mdonahue1/Ltu_FSAE_electric_Temp_sense/(list of files, drawings)

Other design files:
Schematics/Altium/Copy of temp sense 2.0,uhh.PcbDoc
Schematics/Altium/MCU.SchDoc
Schematics/Altium/mux side A (1-4).SchDoc
Schematics/Altium/Mux side B (5-8).SchDoc
Schematics/Altium/power input.SchDoc
Schematics/Altium/temp sense 2.0 top.SchDoc
Schematics/Altium/temp sense 2.0,uhh.PcbDoc
Schematics/Altium/Temp_sense_Project 2.0 - leviathan.PcbDoc
Schematics/Altium/Temp_sense_Project 2.0(right angle.PcbDoc
Schematics/Altium/Temp_sense_Project 2.0.PcbDoc
Schematics/Altium/Temp_sense_Project 2.0.PrjPcb
