mdonahue1/Ltu_FSAE_electric_Temp_sense/Schematics/KiCad/Temp_sense_Project 2.0.kicad_pcb

## KiCad design Schematics/KiCad/Temp_sense_Project 2.0.kicad_pcb (2026-03-20)

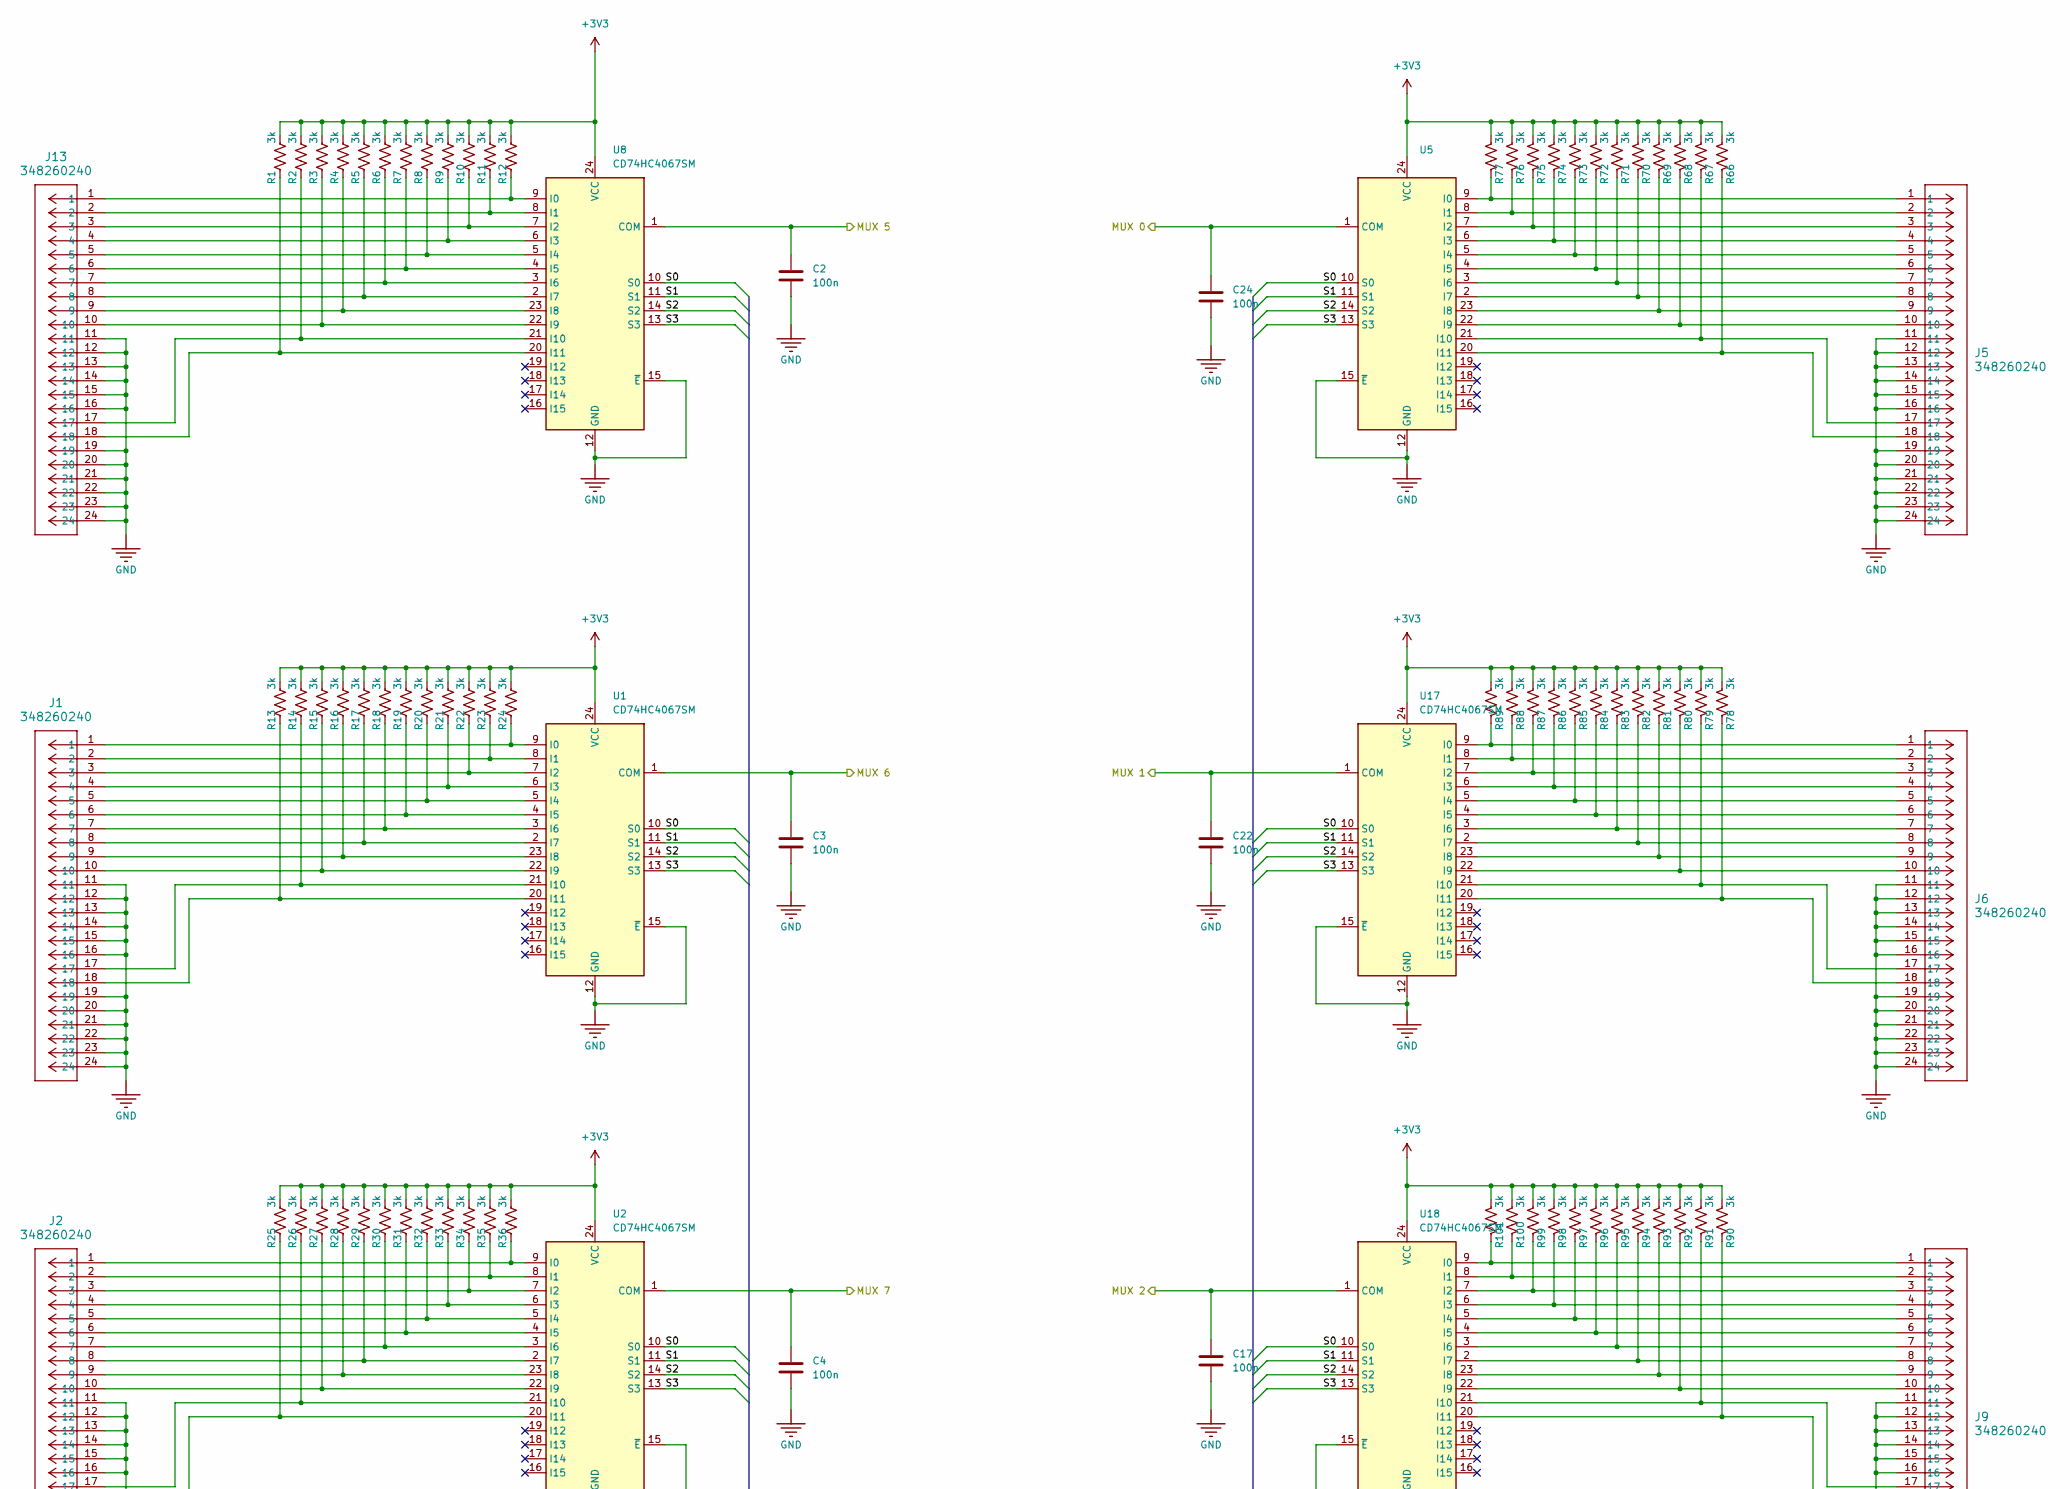
[picture p1: schematic mux side A (1-4).kicad_sch, part in row 1, column 1]

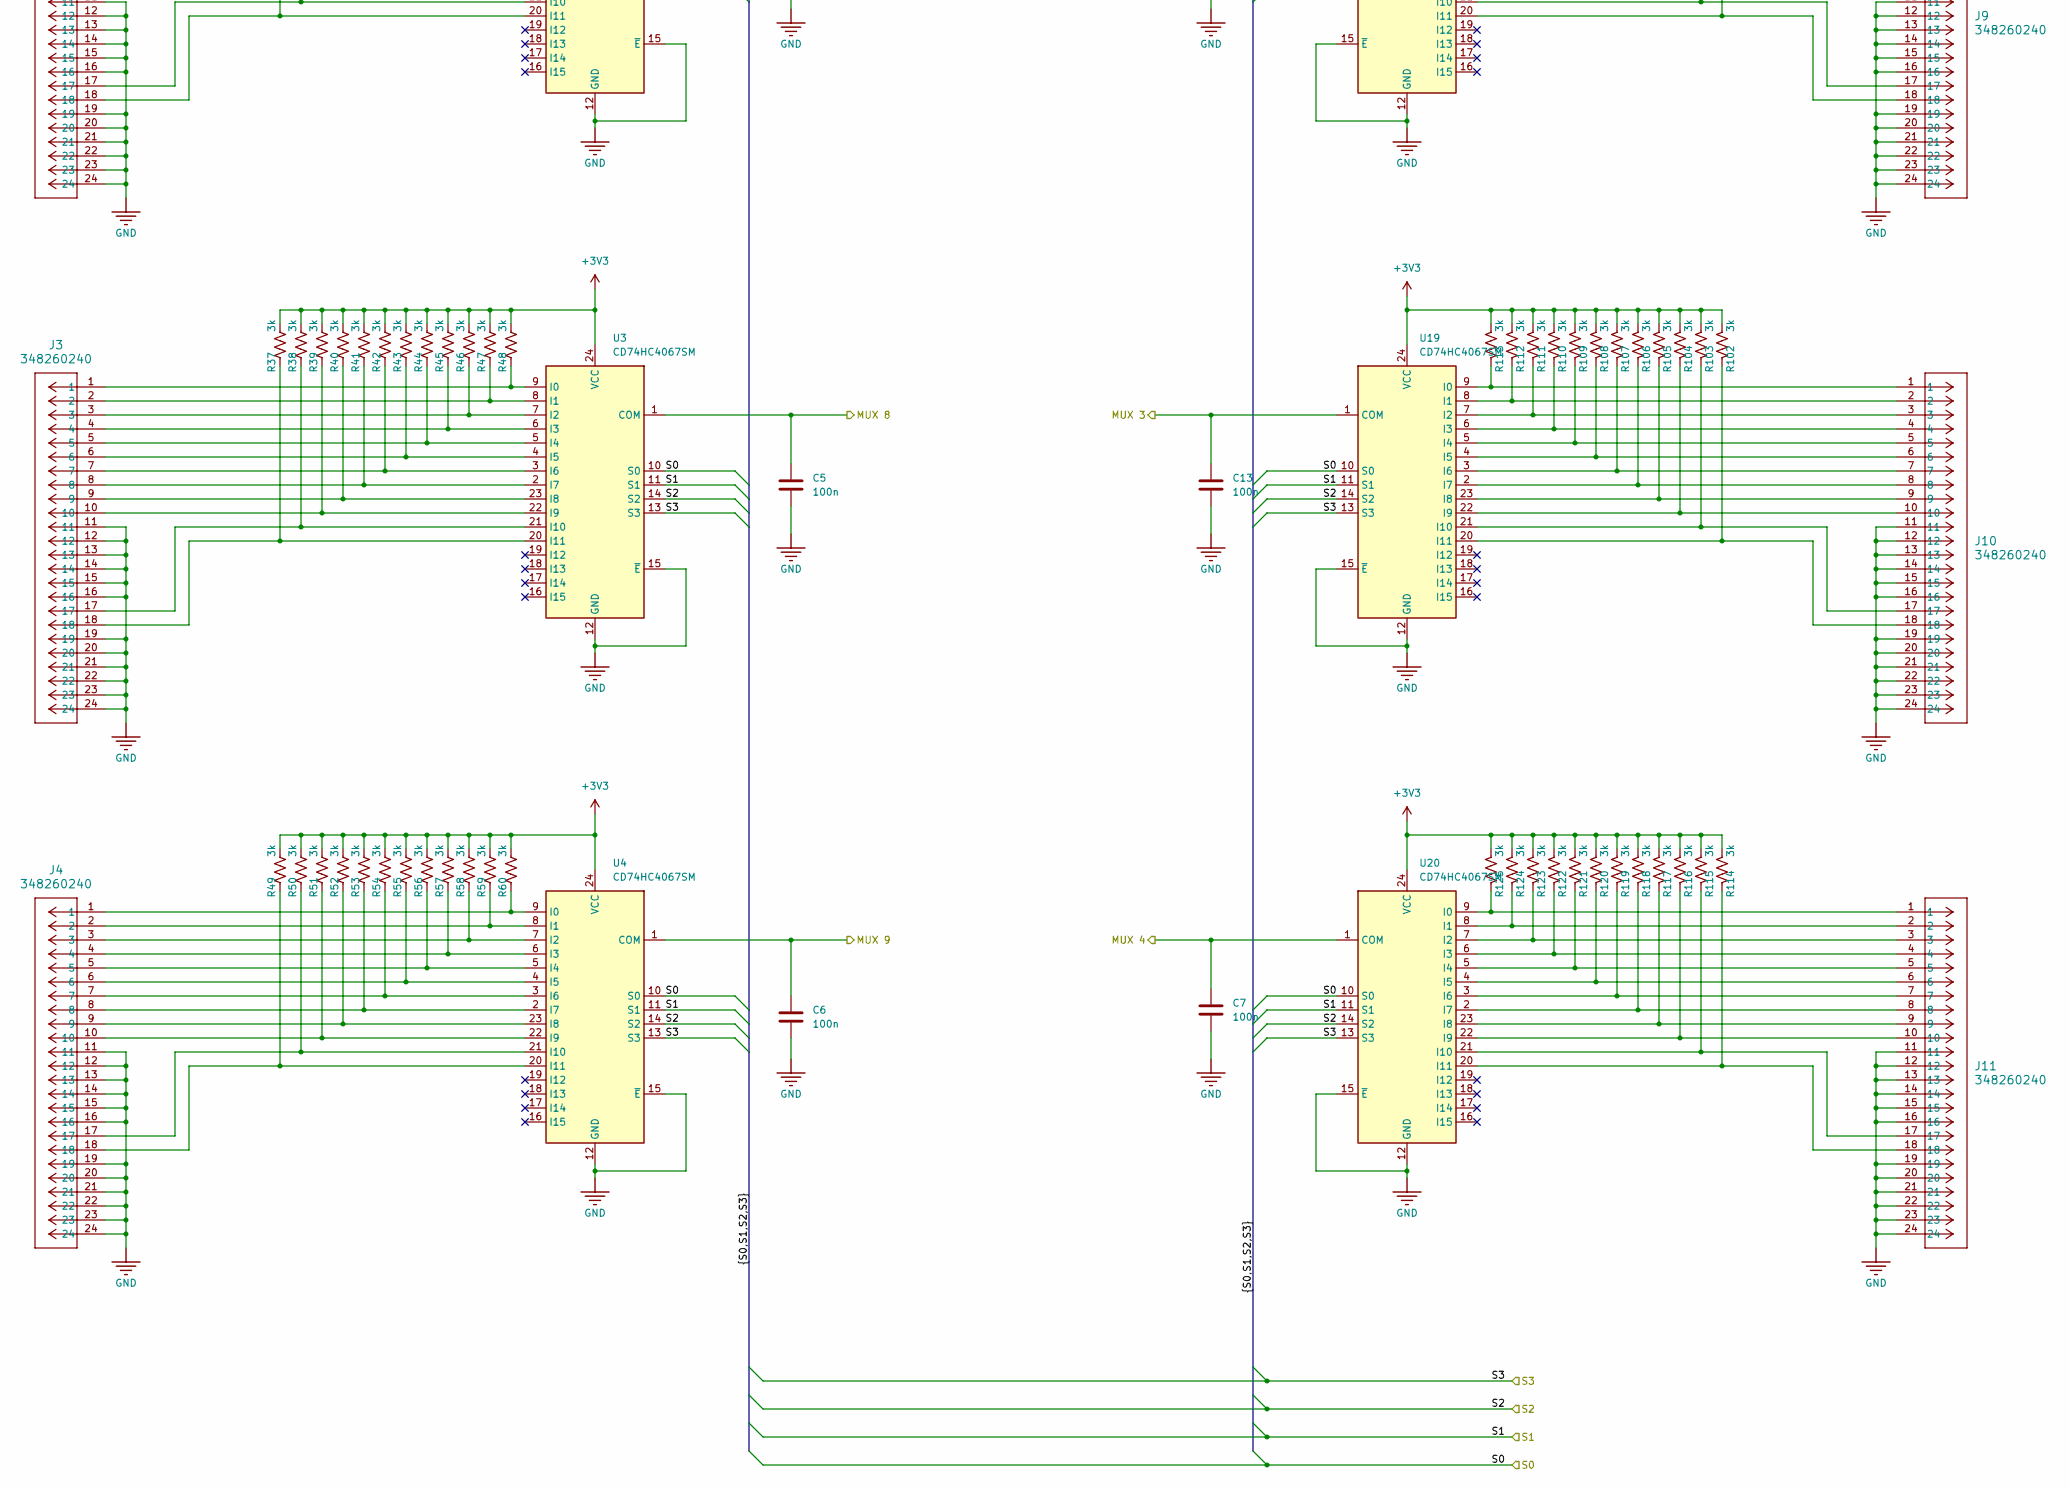
[picture p2: schematic mux side A (1-4).kicad_sch, part in row 2, column 1]

Parts:
C2, C3, C4, C5, C6, C7, C13, C17, C22, C24: 100n; C_0603_1608Metric
J1, J2, J3, J4, J5, J6, J9, J10, J11, J13: 348260240; CONN_SD-34826-001_24_MOL
R1, R2, R3, R4, R5, R6, R7, R8, R9, R10, R11, R12, R13, R14, R15, R16, R17, R18, R19, R20, R21, R22, R23, R24, R25, R26, R27, R28, R29, R30, R31, R32, R33, R34, R35, R36, R37, R38, R39, R40, R41, R42, R43, R44, R45, R46, R47, R48, R49, R50, R51, R52, R53, R54, R55, R56, R57, R58, R59, R60, R66, R67, R68, R69, R70, R71, R72, R73, R74, R75, R76, R77, R78, R79, R80, R81, R82, R83, R84, R85, R86, R87, R88, R89, R90, R91, R92, R93, R94, R95, R96, R97, R98, R99, R100, R101, R102, R103, R104, R105, R106, R107, R108, R109, R110, R111, R112, R113, R114, R115, R116, R117, R118, R119, R120, R121, R122, R123, R124, R125: 3k; R_0603_1608Metric
U1, U2, U3, U4, U5, U8, U17, U18, U19, U20: CD74HC4067SM; SSOP-24_5.3x8.2mm_P0.65mm

Connections:
+3V3: R1.1, R2.1, R3.1, R4.1, R5.1, R6.1, R7.1, R8.1, R9.1, R10.1, R11.1, R12.1, R13.1, R14.1, R15.1, R16.1, R17.1, R18.1, R19.1, R20.1, R21.1, R22.1, R23.1, R24.1, R25.1, R26.1, R27.1, R28.1, R29.1, R30.1, R31.1, R32.1, R33.1, R34.1, R35.1, R36.1, R37.1, R38.1, R39.1, R40.1, R41.1, R42.1, R43.1, R44.1, R45.1, R46.1, R47.1, R48.1, R49.1, R50.1, R51.1, R52.1, R53.1, R54.1, R55.1, R56.1, R57.1, R58.1, R59.1, R60.1, R66.1, R67.1, R68.1, R69.1, R70.1, R71.1, R72.1, R73.1, R74.1, R75.1, R76.1, R77.1, R78.1, R79.1, R80.1, R81.1, R82.1, R83.1, R84.1, R85.1, R86.1, R87.1, R88.1, R89.1, R90.1, R91.1, R92.1, R93.1, R94.1, R95.1, R96.1, R97.1, R98.1, R99.1, R100.1, R101.1, R102.1, R103.1, R104.1, R105.1, R106.1, R107.1, R108.1, R109.1, R110.1, R111.1, R112.1, R113.1, R114.1, R115.1, R116.1, R117.1, R118.1, R119.1, R120.1, R121.1, R122.1, R123.1, R124.1, R125.1, U1.24 (VCC), U2.24 (VCC), U3.24 (VCC), U4.24 (VCC), U5.24 (VCC), U8.24 (VCC), U17.24 (VCC), U18.24 (VCC), U19.24 (VCC), U20.24 (VCC); also elsewhere on the board
/MCU/MUX 0: C24.1, U5.1 (COM); also elsewhere on the board
/MCU/MUX 1: C22.1, U17.1 (COM); also elsewhere on the board
/MCU/MUX 2: C17.1, U18.1 (COM); also elsewhere on the board
/MCU/MUX 3: C13.1, U19.1 (COM); also elsewhere on the board
/MCU/MUX 4: C7.1, U20.1 (COM); also elsewhere on the board
/MCU/MUX 5: C2.1, U8.1 (COM); also elsewhere on the board
/MCU/MUX 6: C3.1, U1.1 (COM); also elsewhere on the board
/MCU/MUX 7: C4.1, U2.1 (COM); also elsewhere on the board
/MCU/MUX 8: C5.1, U3.1 (COM); also elsewhere on the board
/MCU/MUX 9: C6.1, U4.1 (COM); also elsewhere on the board
/MCU/S0: U1.10 (S0), U2.10 (S0), U3.10 (S0), U4.10 (S0), U5.10 (S0), U8.10 (S0), U17.10 (S0), U18.10 (S0), U19.10 (S0), U20.10 (S0); also elsewhere on the board
/MCU/S1: U1.11 (S1), U2.11 (S1), U3.11 (S1), U4.11 (S1), U5.11 (S1), U8.11 (S1), U17.11 (S1), U18.11 (S1), U19.11 (S1), U20.11 (S1); also elsewhere on the board
/MCU/S2: U1.14 (S2), U2.14 (S2), U3.14 (S2), U4.14 (S2), U5.14 (S2), U8.14 (S2), U17.14 (S2), U18.14 (S2), U19.14 (S2), U20.14 (S2); also elsewhere on the board
/MCU/S3: U1.13 (S3), U2.13 (S3), U3.13 (S3), U4.13 (S3), U5.13 (S3), U8.13 (S3), U17.13 (S3), U18.13 (S3), U19.13 (S3), U20.13 (S3); also elsewhere on the board
GND: C2.2, C3.2, C4.2, C5.2, C6.2, C7.2, C13.2, C17.2, C22.2, C24.2, J1.11, J1.12, J1.13, J1.14, J1.15, J1.16, J1.19, J1.20, J1.21, J1.22, J1.23, J1.24, J2.11, J2.12, J2.13, J2.14, J2.15, J2.16, J2.19, J2.20, J2.21, J2.22, J2.23, J2.24, J3.11, J3.12, J3.13, J3.14, J3.15, J3.16, J3.19, J3.20, J3.21, J3.22, J3.23, J3.24, J4.11, J4.12, J4.13, J4.14, J4.15, J4.16, J4.19, J4.20, J4.21, J4.22, J4.23, J4.24, J5.11, J5.12, J5.13, J5.14, J5.15, J5.16, J5.19, J5.20, J5.21, J5.22, J5.23, J5.24, J6.11, J6.12, J6.13, J6.14, J6.15, J6.16, J6.19, J6.20, J6.21, J6.22, J6.23, J6.24, J9.11, J9.12, J9.13, J9.14, J9.15, J9.16, J9.19, J9.20, J9.21, J9.22, J9.23, J9.24, J10.11, J10.12, J10.13, J10.14, J10.15, J10.16, J10.19, J10.20, J10.21, J10.22, J10.23, J10.24, J11.11, J11.12, J11.13, J11.14, J11.15, J11.16, J11.19, J11.20, J11.21, J11.22, J11.23, J11.24, J13.11, J13.12, J13.13, J13.14, J13.15, J13.16, J13.19, J13.20, J13.21, J13.22, J13.23, J13.24, U1.12 (GND), U1.15 (~E), U2.12 (GND), U2.15 (~E), U3.12 (GND), U3.15 (~E), U4.12 (GND), U4.15 (~E), U5.12 (GND), U5.15 (~E), U8.12 (GND), U8.15 (~E), U17.12 (GND), U17.15 (~E), U18.12 (GND), U18.15 (~E), U19.12 (GND), U19.15 (~E), U20.12 (GND), U20.15 (~E); also elsewhere on the board
unnamed: J1.1, R24.2, U1.9 (I0)
unnamed: J1.2, R23.2, U1.8 (I1)
unnamed: J1.3, R22.2, U1.7 (I2)
unnamed: J1.4, R21.2, U1.6 (I3)
unnamed: J1.5, R20.2, U1.5 (I4)
unnamed: J1.6, R19.2, U1.4 (I5)
unnamed: J1.7, R18.2, U1.3 (I6)
unnamed: J1.8, R17.2, U1.2 (I7)
unnamed: J1.9, R16.2, U1.23 (I8)
unnamed: J1.10, R15.2, U1.22 (I9)
unnamed: J1.17, R14.2, U1.21 (I10)
unnamed: J1.18, R13.2, U1.20 (I11)
unnamed: J2.1, R36.2, U2.9 (I0)
unnamed: J2.2, R35.2, U2.8 (I1)
unnamed: J2.3, R34.2, U2.7 (I2)
unnamed: J2.4, R33.2, U2.6 (I3)
unnamed: J2.5, R32.2, U2.5 (I4)
unnamed: J2.6, R31.2, U2.4 (I5)
unnamed: J2.7, R30.2, U2.3 (I6)
unnamed: J2.8, R29.2, U2.2 (I7)
unnamed: J2.9, R28.2, U2.23 (I8)
unnamed: J2.10, R27.2, U2.22 (I9)
unnamed: J2.17, R26.2, U2.21 (I10)
unnamed: J2.18, R25.2, U2.20 (I11)
unnamed: J3.1, R48.2, U3.9 (I0)
unnamed: J3.2, R47.2, U3.8 (I1)
unnamed: J3.3, R46.2, U3.7 (I2)
unnamed: J3.4, R45.2, U3.6 (I3)
unnamed: J3.5, R44.2, U3.5 (I4)
unnamed: J3.6, R43.2, U3.4 (I5)
unnamed: J3.7, R42.2, U3.3 (I6)
unnamed: J3.8, R41.2, U3.2 (I7)
unnamed: J3.9, R40.2, U3.23 (I8)
unnamed: J3.10, R39.2, U3.22 (I9)
unnamed: J3.17, R38.2, U3.21 (I10)
unnamed: J3.18, R37.2, U3.20 (I11)
unnamed: J4.1, R60.2, U4.9 (I0)
unnamed: J4.2, R59.2, U4.8 (I1)
unnamed: J4.3, R58.2, U4.7 (I2)
unnamed: J4.4, R57.2, U4.6 (I3)
unnamed: J4.5, R56.2, U4.5 (I4)
unnamed: J4.6, R55.2, U4.4 (I5)
unnamed: J4.7, R54.2, U4.3 (I6)
unnamed: J4.8, R53.2, U4.2 (I7)
unnamed: J4.9, R52.2, U4.23 (I8)
unnamed: J4.10, R51.2, U4.22 (I9)
unnamed: J4.17, R50.2, U4.21 (I10)
unnamed: J4.18, R49.2, U4.20 (I11)
unnamed: J5.1, R77.2, U5.9 (I0)
unnamed: J5.2, R76.2, U5.8 (I1)
unnamed: J5.3, R75.2, U5.7 (I2)
unnamed: J5.4, R74.2, U5.6 (I3)
unnamed: J5.5, R73.2, U5.5 (I4)
unnamed: J5.6, R72.2, U5.4 (I5)
unnamed: J5.7, R71.2, U5.3 (I6)
unnamed: J5.8, R70.2, U5.2 (I7)
unnamed: J5.9, R69.2, U5.23 (I8)
unnamed: J5.10, R68.2, U5.22 (I9)
unnamed: J5.17, R67.2, U5.21 (I10)
unnamed: J5.18, R66.2, U5.20 (I11)
unnamed: J13.1, R12.2, U8.9 (I0)
unnamed: J13.2, R11.2, U8.8 (I1)
unnamed: J13.3, R10.2, U8.7 (I2)
unnamed: J13.4, R9.2, U8.6 (I3)
unnamed: J13.5, R8.2, U8.5 (I4)
unnamed: J13.6, R7.2, U8.4 (I5)
unnamed: J13.7, R6.2, U8.3 (I6)
unnamed: J13.8, R5.2, U8.2 (I7)
unnamed: J13.9, R4.2, U8.23 (I8)
unnamed: J13.10, R3.2, U8.22 (I9)
unnamed: J13.17, R2.2, U8.21 (I10)
unnamed: J13.18, R1.2, U8.20 (I11)
unnamed: J6.1, R89.2, U17.9 (I0)
unnamed: J6.2, R88.2, U17.8 (I1)
unnamed: J6.3, R87.2, U17.7 (I2)
unnamed: J6.4, R86.2, U17.6 (I3)
unnamed: J6.5, R85.2, U17.5 (I4)
unnamed: J6.6, R84.2, U17.4 (I5)
unnamed: J6.7, R83.2, U17.3 (I6)
unnamed: J6.8, R82.2, U17.2 (I7)
unnamed: J6.9, R81.2, U17.23 (I8)
unnamed: J6.10, R80.2, U17.22 (I9)
unnamed: J6.17, R79.2, U17.21 (I10)
unnamed: J6.18, R78.2, U17.20 (I11)
unnamed: J9.1, R101.2, U18.9 (I0)
unnamed: J9.2, R100.2, U18.8 (I1)
unnamed: J9.3, R99.2, U18.7 (I2)
unnamed: J9.4, R98.2, U18.6 (I3)
unnamed: J9.5, R97.2, U18.5 (I4)
unnamed: J9.6, R96.2, U18.4 (I5)
unnamed: J9.7, R95.2, U18.3 (I6)
unnamed: J9.8, R94.2, U18.2 (I7)
unnamed: J9.9, R93.2, U18.23 (I8)
unnamed: J9.10, R92.2, U18.22 (I9)
unnamed: J9.17, R91.2, U18.21 (I10)
unnamed: J9.18, R90.2, U18.20 (I11)
unnamed: J10.1, R113.2, U19.9 (I0)
unnamed: J10.2, R112.2, U19.8 (I1)
unnamed: J10.3, R111.2, U19.7 (I2)
unnamed: J10.4, R110.2, U19.6 (I3)
unnamed: J10.5, R109.2, U19.5 (I4)
unnamed: J10.6, R108.2, U19.4 (I5)
unnamed: J10.7, R107.2, U19.3 (I6)
unnamed: J10.8, R106.2, U19.2 (I7)
unnamed: J10.9, R105.2, U19.23 (I8)
unnamed: J10.10, R104.2, U19.22 (I9)
unnamed: J10.17, R103.2, U19.21 (I10)
unnamed: J10.18, R102.2, U19.20 (I11)
unnamed: J11.1, R125.2, U20.9 (I0)
unnamed: J11.2, R124.2, U20.8 (I1)
unnamed: J11.3, R123.2, U20.7 (I2)
unnamed: J11.4, R122.2, U20.6 (I3)
unnamed: J11.5, R121.2, U20.5 (I4)
unnamed: J11.6, R120.2, U20.4 (I5)
unnamed: J11.7, R119.2, U20.3 (I6)
unnamed: J11.8, R118.2, U20.2 (I7)
unnamed: J11.9, R117.2, U20.23 (I8)
unnamed: J11.10, R116.2, U20.22 (I9)
unnamed: J11.17, R115.2, U20.21 (I10)
unnamed: J11.18, R114.2, U20.20 (I11)

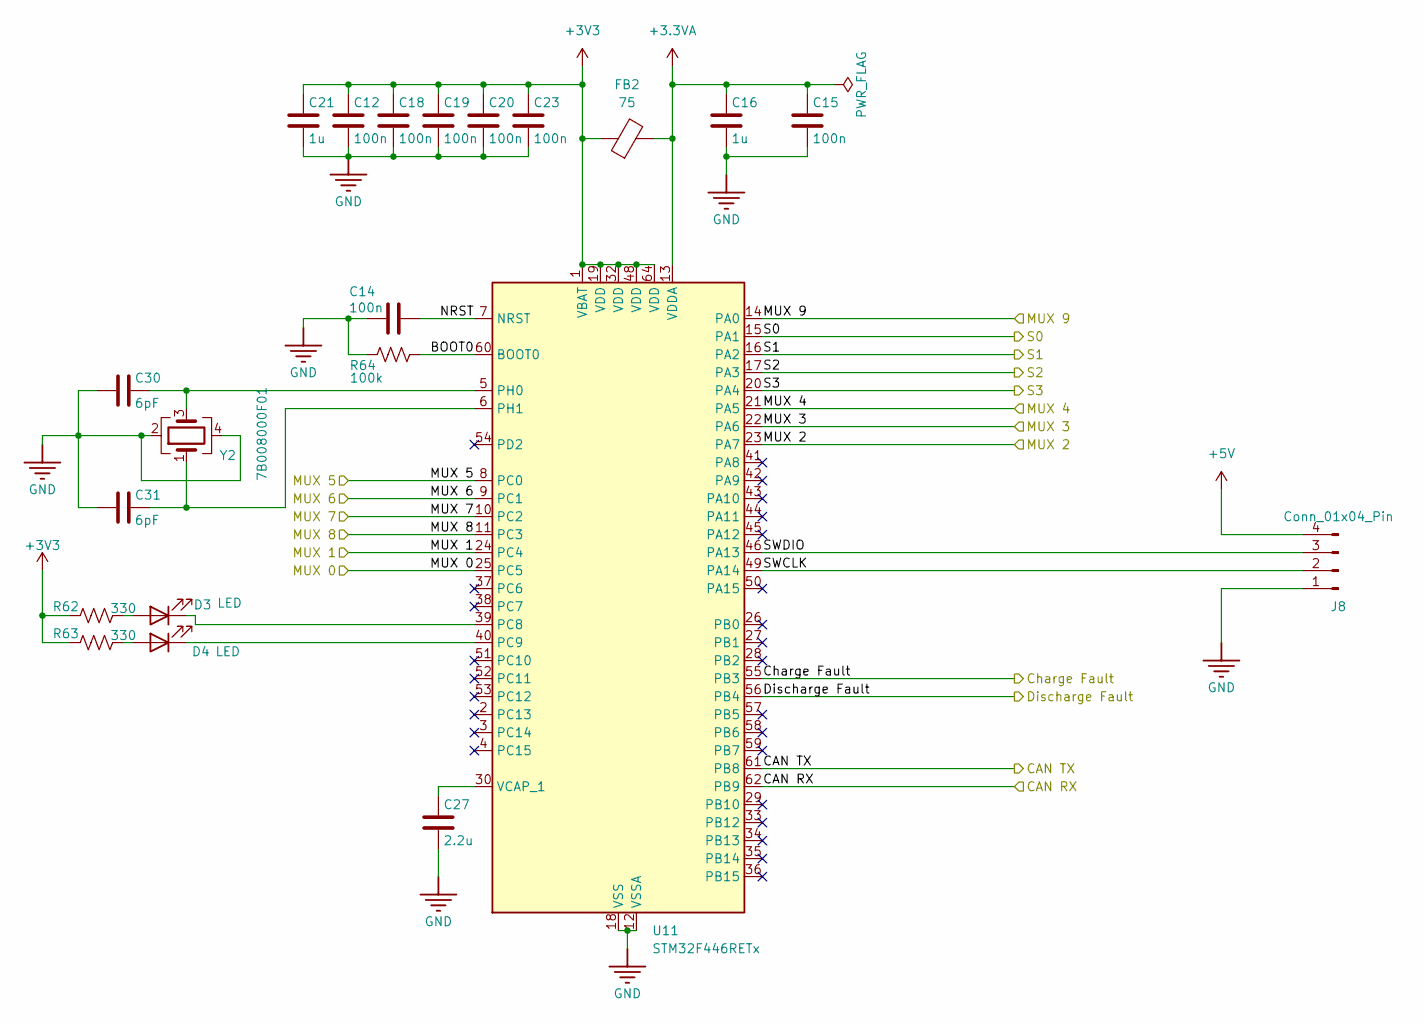
[picture p3: schematic MCU.kicad_sch, 2026 temp sense-mcu]

Parts:
C12, C14, C15, C18, C19, C20, C23: 100n; C_0603_1608Metric
C16, C21: 1u; C_0603_1608Metric
C27: 2.2u; C_0603_1608Metric
C30, C31: 6pF; C_0402_1005Metric; MPN GJM1555C1H6R0CB01D; JLCPCB Part # C161330
D3, D4: LED; LED_0603_1608Metric
FB2: 75; R_0603_1608Metric
J8: Conn_01x04_Pin; PinHeader_1x04_P2.54mm_Vertical
R62, R63: 330; R_0603_1608Metric
R64: 100k; R_0603_1608Metric
U11: STM32F446RETx; LQFP-64_10x10mm_P0.5mm
Y2: 7B008000F01; Crystal_SMD_3225-4Pin_3.2x2.5mm; MPN 7B008000F01; JLCPCB Part # C648984

Connections:
+3.3VA: C15.1, C16.1, FB2.2, U11.13 (VDDA)
+3V3: C12.1, C18.1, C19.1, C20.1, C21.1, C23.1, FB2.1, R62.1, R63.1, U11.1 (VBAT), U11.19 (VDD), U11.32 (VDD), U11.48 (VDD), U11.64 (VDD); also elsewhere on the board
+5V: J8.4; also elsewhere on the board
/MCU/BOOT0: R64.1, U11.60 (BOOT0)
/MCU/CAN RX: U11.62 (PB9); also elsewhere on the board
/MCU/CAN TX: U11.61 (PB8); also elsewhere on the board
/MCU/Charge Fault: U11.55 (PB3); also elsewhere on the board
/MCU/Discharge Fault: U11.56 (PB4); also elsewhere on the board
/MCU/MUX 0: U11.25 (PC5); also elsewhere on the board
/MCU/MUX 1: U11.24 (PC4); also elsewhere on the board
/MCU/MUX 2: U11.23 (PA7); also elsewhere on the board
/MCU/MUX 3: U11.22 (PA6); also elsewhere on the board
/MCU/MUX 4: U11.21 (PA5); also elsewhere on the board
/MCU/MUX 5: U11.8 (PC0); also elsewhere on the board
/MCU/MUX 6: U11.9 (PC1); also elsewhere on the board
/MCU/MUX 7: U11.10 (PC2); also elsewhere on the board
/MCU/MUX 8: U11.11 (PC3); also elsewhere on the board
/MCU/MUX 9: U11.14 (PA0); also elsewhere on the board
/MCU/NRST: C14.1, U11.7 (NRST)
/MCU/S0: U11.15 (PA1); also elsewhere on the board
/MCU/S1: U11.16 (PA2); also elsewhere on the board
/MCU/S2: U11.17 (PA3); also elsewhere on the board
/MCU/S3: U11.20 (PA4); also elsewhere on the board
/MCU/SWCLK: J8.2, U11.49 (PA14)
/MCU/SWDIO: J8.3, U11.46 (PA13)
GND: C12.2, C14.2, C15.2, C16.2, C18.2, C19.2, C20.2, C21.2, C23.2, C27.2, C30.2, C31.2, J8.1, R64.2, U11.12 (VSSA), U11.18 (VSS), U11.31 (VSS), U11.47 (VSS), U11.63 (VSS), Y2.2, Y2.4; also elsewhere on the board
unnamed: D3.2 (A), R62.2
unnamed: D3.1 (K), U11.39 (PC8)
unnamed: D4.2 (A), R63.2
unnamed: D4.1 (K), U11.40 (PC9)
unnamed: C30.1, U11.5 (PH0), Y2.3
unnamed: C31.1, U11.6 (PH1), Y2.1
unnamed: C27.1, U11.30 (VCAP_1)

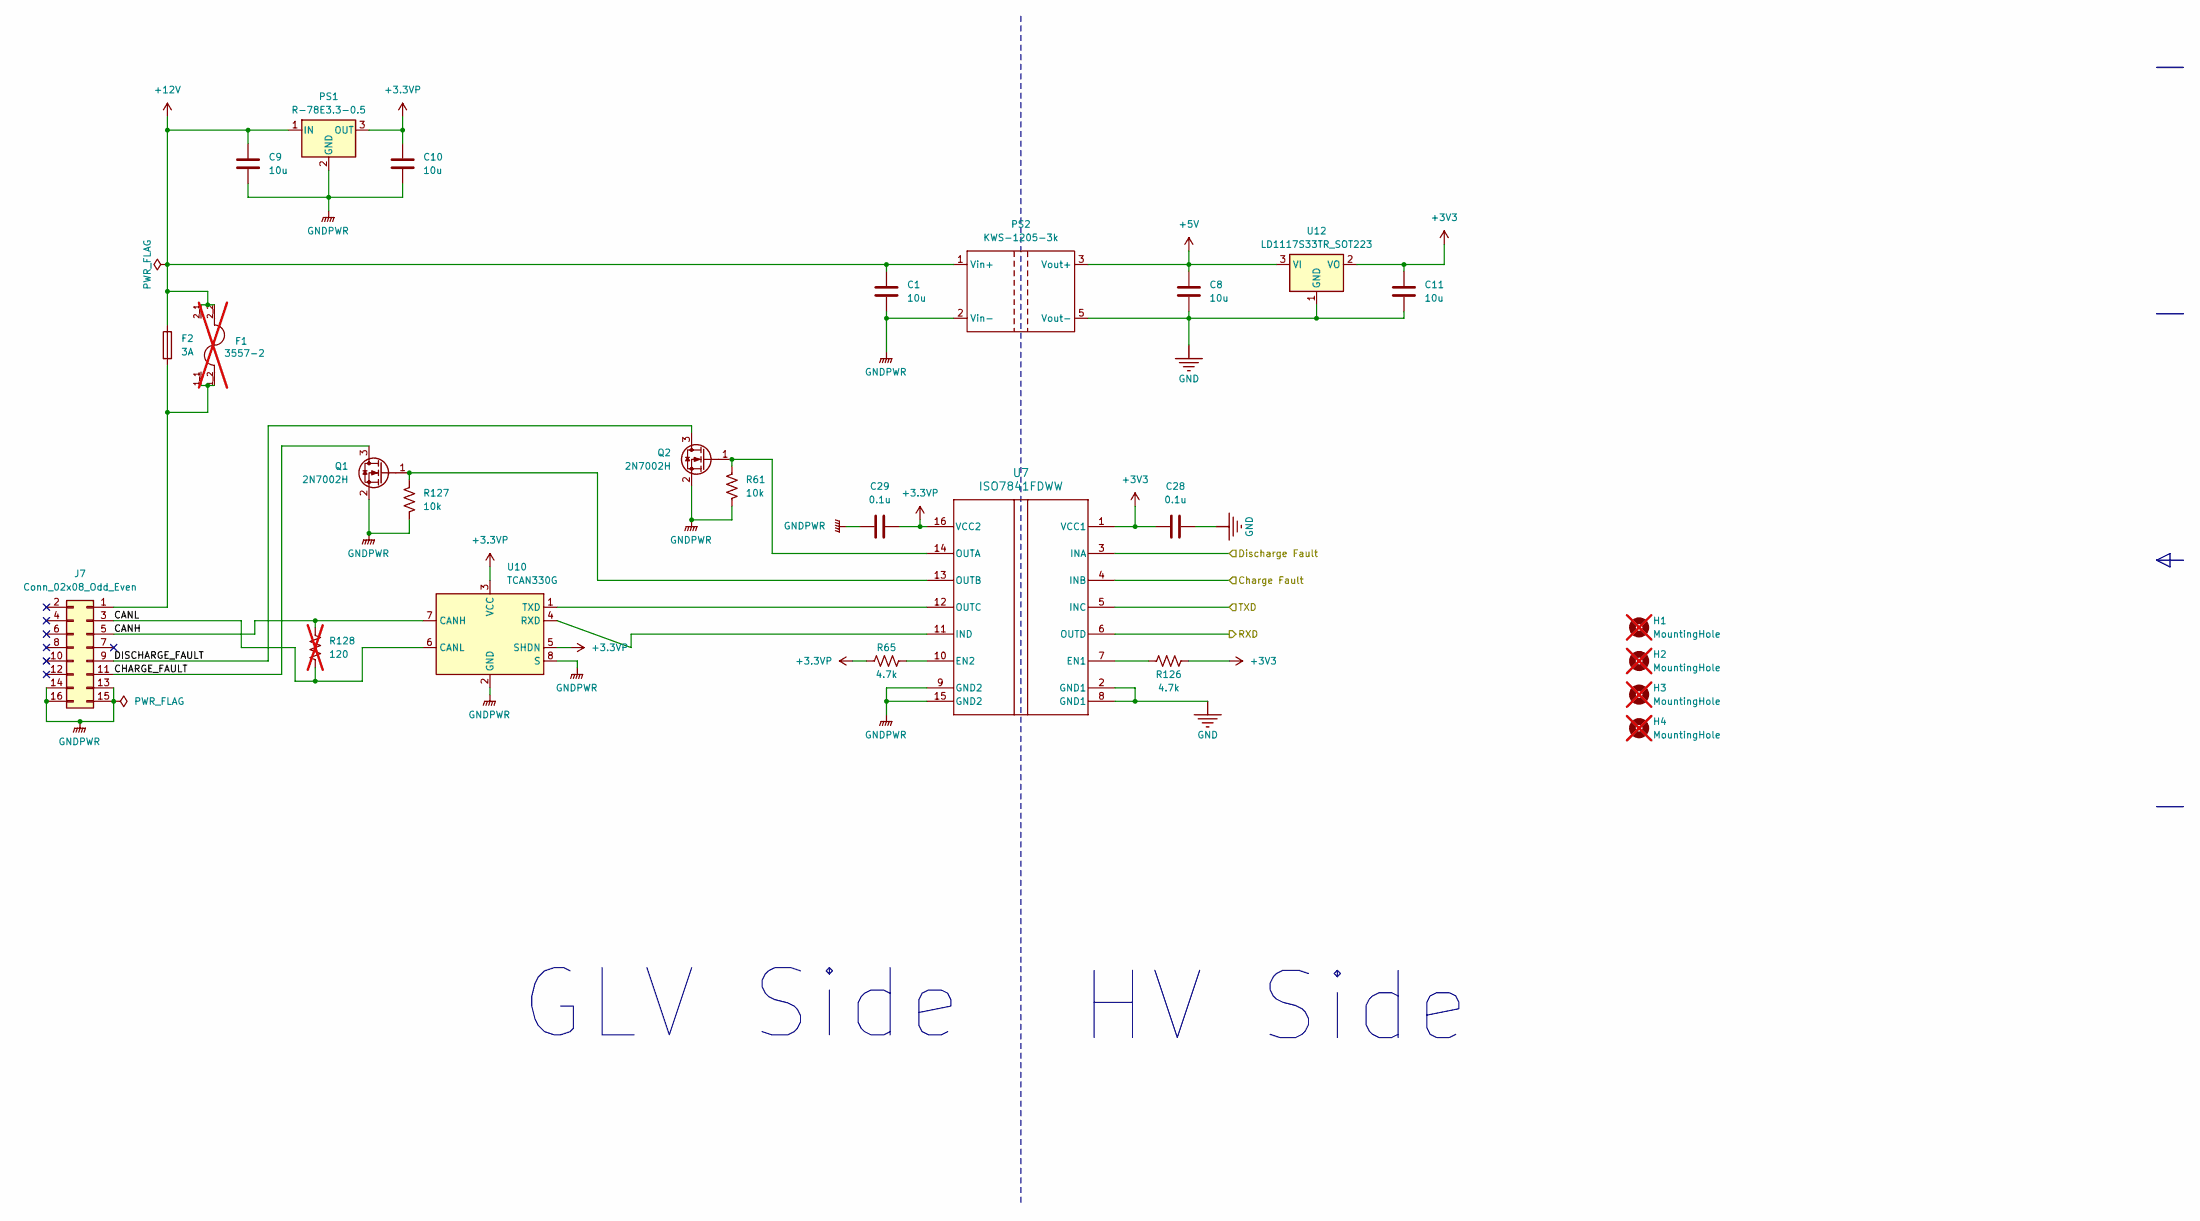
[picture p4: schematic power input.kicad_sch]

Parts:
C1, C8, C9, C10, C11: 10u; C_0603_1608Metric
C28, C29: 0.1u; C_0603_1608Metric
F1: 3557-2; FUSE_3557-2; PARTREV D; not fitted
F2: 3A; Fuse_0603_1608Metric; MPN SF-0603S300-2
H1, H2, H3, H4: MountingHole; MountingHole_6.4mm_M6; not fitted
J7: Conn_02x08_Odd_Even; PinSocket_2x08_P2.00mm_Vertical; MPN B16B-PHDSS
PS1: R-78E3.3-0.5; Converter_DCDC_RECOM_R-78E-0.5_THT
PS2: KWS-1205-3k; KWS-1205-3K
Q1, Q2: 2N7002H; SOT-23
R61, R127: 10k; R_0603_1608Metric
R65, R126: 4.7k; R_0603_1608Metric
R128: 120; R_0603_1608Metric; not fitted
U7: ISO7841FDWW; DWW0016A_N; MPN ISO7841FDWW
U10: TCAN330G
U12: LD1117S33TR_SOT223; SOT-223-3_TabPin2

Connections:
+3.3VP: C10.1, C29.1, PS1.3 (OUT), R65.1, U7.16 (VCC2), U10.3 (VCC), U10.5 (SHDN)
+3V3: C11.1, C28.1, R126.2, U7.1 (VCC1), U12.2 (VO); also elsewhere on the board
+5V: C8.1, PS2.3 (Vout+), U12.3 (VI); also elsewhere on the board
+12V: C1.1, C9.1, F1.2_1, F1.2_2, F2.1, PS1.1 (IN), PS2.1 (Vin+)
/MCU/CAN RX: U7.6 (OUTD); also elsewhere on the board
/MCU/CAN TX: U7.5 (INC); also elsewhere on the board
/MCU/Charge Fault: U7.4 (INB); also elsewhere on the board
/MCU/Discharge Fault: U7.3 (INA); also elsewhere on the board
/Power and Isolation/CANH: J7.5, R128.1, U10.7 (CANH)
/Power and Isolation/CANL: J7.3, R128.2, U10.6 (CANL)
/Power and Isolation/CHARGE_FAULT: J7.11, Q1.3 (D)
/Power and Isolation/DISCHARGE_FAULT: J7.9, Q2.3 (D)
GND: C8.2, C11.2, C28.2, PS2.5 (Vout-), U7.2 (GND1), U7.8 (GND1), U12.1 (GND); also elsewhere on the board
GNDPWR: C1.2, C9.2, C10.2, C29.2, J7.13, J7.14, J7.15, J7.16, PS1.2 (GND), PS2.2 (Vin-), Q1.2 (S), Q2.2 (S), R61.2, R127.2, U7.9 (GND2), U7.15 (GND2), U10.2 (GND), U10.8 (S)
unnamed: F1.1_1, F1.1_2, F2.2, J7.1
unnamed: Q1.1 (G), R127.1, U7.13 (OUTB)
unnamed: Q2.1 (G), R61.1, U7.14 (OUTA)
unnamed: R126.1, U7.7 (EN1)
unnamed: R65.2, U7.10 (EN2)
unnamed: U7.11 (IND), U10.4 (RXD)
unnamed: U7.12 (OUTC), U10.1 (TXD)

Notes on the sheet:
GLV Side
HV Side

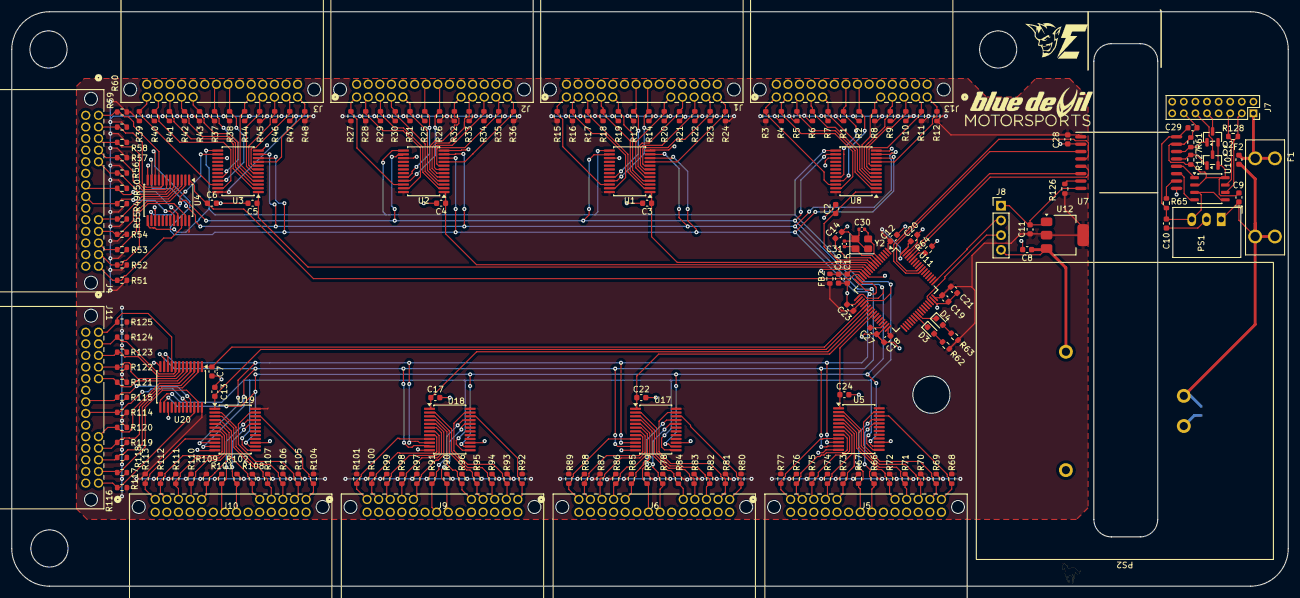
[picture p5: board Temp_sense_Project 2.0.kicad_pcb from above]

Board: 2 copper layers, 220.0 x 99.0 mm, 197 parts (1 on the bottom side), 167 nets.
