mdonahue1/Ltu_FSAE_electric_Temp_sense/Core/Src/main.c

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
/* Includes ------------------------------------------------------------------*/
#include "main.h"
#include "adc.h"
#include "can.h"
#include "dma.h"
#include "tim.h"
#include "gpio.h"

/* USER CODE BEGIN Includes */
#include <stdint.h>
#include <string.h>

#include "temp_sense.h"
/* USER CODE END Includes */


/* USER CODE BEGIN PV */

volatile uint32_t tempBuffer[MUX_BANK_COUNT];

CAN_RxHeaderTypeDef rxHeaderFIFO0;
uint8_t dataFIFO0[8] = { (0x00U) };
/* USER CODE END PV */

void SystemClock_Config(void);
/* USER CODE BEGIN PFP */
static void     selectMuxChannel(uint8_t channel);
static Result_t sendCanMessage(uint32_t canStdId, CanData_t data, uint32_t dlc);
static void     setFaultLine(FaultLine_e faultLine);
static void     clearFaultLine(FaultLine_e faultLine);
/* USER CODE END PFP */

/* USER CODE BEGIN 0 */
void HAL_CAN_RxFifo0MsgPendingCallback(CAN_HandleTypeDef *hcan)
{
  /* Prevent unused argument(s) compilation warning */
  //UNUSED(hcan);

  if (hcan->Instance == CAN1)
  {
    HAL_CAN_GetRxMessage(hcan, CAN_RX_FIFO0, &rxHeaderFIFO0, dataFIFO0);
    CanData_t data;
    memcpy(data.data8, dataFIFO0, sizeof(data.data8));
    handle_can_message(rxHeaderFIFO0.StdId, data, rxHeaderFIFO0.DLC);
  }

  /* NOTE : This function Should not be modified, when the callback is needed,
            the HAL_CAN_RxFifo0MsgPendingCallback could be implemented in the
            user file
   */
}

void HAL_ADC_ConvCpltCallback(ADC_HandleTypeDef* hadc) {
  update_raw_temperatures((uint32_t *)tempBuffer);
}
/* USER CODE END 0 */

/**
  * @brief  The application entry point.
  * @retval int
  */
int main(void)
{

  /* MCU Configuration--------------------------------------------------------*/

  /* Reset of all peripherals, Initializes the Flash interface and the Systick. */
  HAL_Init();

  /* USER CODE BEGIN Init */
  memset((void *) tempBuffer, 0, sizeof(tempBuffer));
  /* USER CODE END Init */

  /* Configure the system clock */
  SystemClock_Config();

  /* Initialize all configured peripherals */
  MX_GPIO_Init();
  MX_DMA_Init();
  MX_ADC1_Init();
  MX_TIM2_Init();
  MX_CAN1_Init();
  /* USER CODE BEGIN 2 */

  TempSenseInit_t tempSenseInit = {
      .selectMuxCell = selectMuxChannel,
      .sendCanMessage = sendCanMessage,
      .setFault = setFaultLine,
      .clearFault = clearFaultLine
  };
  initialize_temp_sense(tempSenseInit);

  if (HAL_ADC_Start_DMA (&hadc1, (uint32_t*) tempBuffer, MUX_BANK_COUNT) != HAL_OK) {
    Error_Handler();
  }
  if (HAL_TIM_Base_Start(&htim2) != HAL_OK) {
    Error_Handler();
  }

  if (HAL_CAN_Start(&hcan1) != HAL_OK) {
    Error_Handler();
  }

  HAL_CAN_ActivateNotification(&hcan1, CAN_IT_RX_FIFO0_MSG_PENDING);
  TS_ECU_ChargingStateTrigFilterConfig();
  TS_ECU_SYNC_RX1_FilterConfig();
  TS_ECU_SYNC_RX2_FilterConfig();
  /* USER CODE END 2 */

  /* Infinite loop */
  /* USER CODE BEGIN WHILE */
  HAL_Delay(150);
  while (1)
  {
    /* USER CODE END WHILE */

    /* USER CODE BEGIN 3 */
    loop();
  }
  /* USER CODE END 3 */
}

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
/* USER CODE BEGIN 4 */
static void selectMuxChannel(uint8_t channel) {
  HAL_GPIO_WritePin(S0_GPIO_Port, S0_Pin, (channel & 0b0001) ? GPIO_PIN_SET : GPIO_PIN_RESET);
  HAL_GPIO_WritePin(S1_GPIO_Port, S1_Pin, (channel & 0b0010) ? GPIO_PIN_SET : GPIO_PIN_RESET);
  HAL_GPIO_WritePin(S2_GPIO_Port, S2_Pin, (channel & 0b0100) ? GPIO_PIN_SET : GPIO_PIN_RESET);
  HAL_GPIO_WritePin(S3_GPIO_Port, S3_Pin, (channel & 0b1000) ? GPIO_PIN_SET : GPIO_PIN_RESET);
}

static Result_t sendCanMessage(uint32_t canStdId, CanData_t data, uint32_t dlc) {
  CAN_TxHeaderTypeDef txHeader = {
      .StdId = canStdId,
      .ExtId = (uint32_t)0,
      .RTR = CAN_RTR_DATA,
      .IDE = CAN_ID_STD,
      .DLC = dlc
  };
  uint32_t mailbox = 0;

  if (HAL_CAN_AddTxMessage(&hcan1, &txHeader, data.data8, &mailbox) != HAL_OK) {
    return RESULT_FAILED;
  }

  uint32_t startTick = HAL_GetTick();
  while(HAL_CAN_IsTxMessagePending(&hcan1, mailbox)) {
    if ((HAL_GetTick() - startTick) > 5) {
      return RESULT_FAILED;
    }
  }

  return RESULT_OK;
}

void setFaultLine(FaultLine_e faultLine) {
  if (faultLine & DISCHARGE_TEMP_FAULT) {
    HAL_GPIO_WritePin(Discharge_Fault_GPIO_Port, Discharge_Fault_Pin, GPIO_PIN_SET);
  } else if (faultLine & CHARGE_TEMP_FAULT) {
    HAL_GPIO_WritePin(Charge_Fault_GPIO_Port, Charge_Fault_Pin, GPIO_PIN_SET);
  }
}

void clearFaultLine(FaultLine_e faultLine) {
  if (faultLine & DISCHARGE_TEMP_FAULT) {
    HAL_GPIO_WritePin(Discharge_Fault_GPIO_Port, Discharge_Fault_Pin, GPIO_PIN_RESET);
  } else if (faultLine & CHARGE_TEMP_FAULT) {
    HAL_GPIO_WritePin(Charge_Fault_GPIO_Port, Charge_Fault_Pin, GPIO_PIN_RESET);
  }
}
/* USER CODE END 4 */
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
