mdonahue1/Ltu_FSAE_electric_Temp_sense/Core/Src/can.c

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
/* Includes ------------------------------------------------------------------*/
#include "can.h"

CAN_HandleTypeDef hcan1;

/* CAN1 init function */
void MX_CAN1_Init(void)
{

  hcan1.Instance = CAN1;
  hcan1.Init.Prescaler = 6;
  hcan1.Init.Mode = CAN_MODE_NORMAL;
  hcan1.Init.SyncJumpWidth = CAN_SJW_1TQ;
  hcan1.Init.TimeSeg1 = CAN_BS1_7TQ;
  hcan1.Init.TimeSeg2 = CAN_BS2_7TQ;
  hcan1.Init.TimeTriggeredMode = DISABLE;
  hcan1.Init.AutoBusOff = DISABLE;
  hcan1.Init.AutoWakeUp = DISABLE;
  hcan1.Init.AutoRetransmission = DISABLE;
  hcan1.Init.ReceiveFifoLocked = DISABLE;
  hcan1.Init.TransmitFifoPriority = DISABLE;
  if (HAL_CAN_Init(&hcan1) != HAL_OK)
  {
    Error_Handler();
  }
}

void HAL_CAN_MspInit(CAN_HandleTypeDef* canHandle)
{

  GPIO_InitTypeDef GPIO_InitStruct = {0};
  if(canHandle->Instance==CAN1)
  {
    /* CAN1 clock enable */
    __HAL_RCC_CAN1_CLK_ENABLE();

    __HAL_RCC_GPIOB_CLK_ENABLE();
    /**CAN1 GPIO Configuration
    PB8     ------> CAN1_RX
    PB9     ------> CAN1_TX
    */
    GPIO_InitStruct.Pin = GPIO_PIN_8|GPIO_PIN_9;
    GPIO_InitStruct.Mode = GPIO_MODE_AF_PP;
    GPIO_InitStruct.Pull = GPIO_NOPULL;
    GPIO_InitStruct.Speed = GPIO_SPEED_FREQ_VERY_HIGH;
    GPIO_InitStruct.Alternate = GPIO_AF9_CAN1;
    HAL_GPIO_Init(GPIOB, &GPIO_InitStruct);

  }
}

void HAL_CAN_MspDeInit(CAN_HandleTypeDef* canHandle)
{

  if(canHandle->Instance==CAN1)
  {
    /* Peripheral clock disable */
    __HAL_RCC_CAN1_CLK_DISABLE();

    /**CAN1 GPIO Configuration
    PB8     ------> CAN1_RX
    PB9     ------> CAN1_TX
    */
    HAL_GPIO_DeInit(GPIOB, GPIO_PIN_8|GPIO_PIN_9);

  }
}

/* USER CODE BEGIN 1 */
void TS_ECU_SYNC_RX1_FilterConfig(void)
{
  CAN_FilterTypeDef filter;

  filter.FilterActivation = CAN_FILTER_ENABLE;
  filter.FilterBank = 0;
  filter.FilterFIFOAssignment = CAN_FILTER_FIFO0;
  filter.FilterIdHigh = (TS_ECU_SYNC_RX1_CANID << 5);
  filter.FilterIdLow = (0x000U);
  filter.FilterMaskIdHigh = (TS_ECU_SYNC_RX1_CANID << 5);
  filter.FilterMaskIdLow = (0x000U);
  filter.FilterMode = CAN_FILTERMODE_IDLIST;
  filter.FilterScale = CAN_FILTERSCALE_32BIT;
  filter.SlaveStartFilterBank = 15;

  if (HAL_CAN_ConfigFilter(&hcan1, &filter) != HAL_OK)
  {
    Error_Handler();
  }
}

void TS_ECU_SYNC_RX2_FilterConfig(void)
{
  CAN_FilterTypeDef filter;

  filter.FilterActivation = CAN_FILTER_ENABLE;
  filter.FilterBank = 1;
  filter.FilterFIFOAssignment = CAN_FILTER_FIFO0;
  filter.FilterIdHigh = (TS_ECU_SYNC_RX2_CANID << 5);
  filter.FilterIdLow = (0x000U);
  filter.FilterMaskIdHigh = (TS_ECU_SYNC_RX2_CANID << 5);
  filter.FilterMaskIdLow = (0x000U);
  filter.FilterMode = CAN_FILTERMODE_IDLIST;
  filter.FilterScale = CAN_FILTERSCALE_32BIT;
  filter.SlaveStartFilterBank = 15;

  if (HAL_CAN_ConfigFilter(&hcan1, &filter) != HAL_OK)
  {
    Error_Handler();
  }
}

void TS_ECU_ChargingStateTrigFilterConfig(void)
{
  CAN_FilterTypeDef filter;

  filter.FilterActivation = CAN_FILTER_ENABLE;
  filter.FilterBank = 2;
  filter.FilterFIFOAssignment = CAN_FILTER_FIFO0;
  filter.FilterIdHigh = (TS_ECU_ChargingStateTrigger_CANID << 5);
  filter.FilterIdLow = (0x000U);
  filter.FilterMaskIdHigh = (TS_ECU_ChargingStateTrigger_CANID << 5);
  filter.FilterMaskIdLow = (0x000U);
  filter.FilterMode = CAN_FILTERMODE_IDLIST;
  filter.FilterScale = CAN_FILTERSCALE_32BIT;
  filter.SlaveStartFilterBank = 15;

  if (HAL_CAN_ConfigFilter(&hcan1, &filter) != HAL_OK)
  {
    Error_Handler();
  }
}
/* USER CODE END 1 */
