mdonahue1/Ltu_FSAE_electric_Temp_sense/(commit log)

2026-01-27 Add files via upload
    temp sense board project as of 1/20/26
    [Copy of temp sense 2.0,uhh.PcbDoc, MCU.SchDoc, Mux side B (5-8).SchDoc, Temp_sense_Project 2.0 - leviathan.PcbDoc, Temp_sense_Project 2.0(right angle.PcbDoc, Temp_sense_Project 2.0.PcbDoc, Temp_sense_Project 2.0.PrjPcb, mux side A (1-4).SchDoc]
2026-02-05 Add files via upload
    temp sense as of 2-5-26
    [MCU.SchDoc, Temp_sense_Project 2.0(right angle.PcbDoc, Temp_sense_Project 2.0.PrjPcb, power input.SchDoc, temp sense 2.0 top.SchDoc]
2026-03-10 Add KiCad Schematics. Clean up misc stuff.
    [Copy of temp sense 2.0,uhh.PcbDoc, MCU.SchDoc, MCU.kicad_sch, Mux side B (5-8).SchDoc, Mux side B (5-8).kicad_sch, TempSense.kicad_pcb, TempSense.kicad_sch, Temp_sense_Project 2.0 - leviathan.PcbDoc]
2026-03-11 Fix all errors and warnings
    [MCU.kicad_sch, Temp_sense_Project 2.0.kicad_sch, mux side A (1-4).kicad_sch, power input.kicad_sch]
2026-03-12 Fix a few bugs and start writing main temp sense logic
    [can.c, can.h, main.c]
2026-03-12 Update schematics
    [MCU.kicad_sch]
2026-03-14 Add checks for minimum temperatures
2026-03-14 Skip bad readings from stats in summary
    [temp_sense.c, temp_sense.h]
2026-03-16 Condense layout to 2 layers
    [MCU.kicad_sch, Temp_sense_Project 2.0.kicad_pcb, Temp_sense_Project 2.0.kicad_sch, mux side A (1-4).kicad_sch, power input.kicad_sch]
2026-03-17 More pcb layout work
    [MCU.kicad_sch, Temp_sense_Project 2.0.kicad_pcb]
2026-03-17 continued net work
    idk how tf kicad works hopefully we dont need all 30 files
    [Temp_sense_Project 2.0.kicad_pcb]
2026-03-18 pcb file changed to not error out kicad
    also finished a few routes I missed
    [Temp_sense_Project 2.0.kicad_pcb]
2026-03-20 Get rid of excess files
    [MCU.kicad_sch, Temp_sense_Project 2.0.kicad_pcb]
2026-03-20 Move some silkscreen around
    [TempSense.kicad_pcb, TempSense.kicad_sch, Temp_sense_Project 2.0.kicad_pcb]
