mdonahue1/Ltu_FSAE_electric_Temp_sense/(notices)

Notices in the files:
Core/Inc/main.h:
Copyright (c) 2025 STMicroelectronics.
All rights reserved.
This software is licensed under terms that can be found in the LICENSE file
Core/Inc/can.h:
Copyright (c) 2026 STMicroelectronics.
